Garal97/DMD/Python/Others/test.py

#import os

#txt_files = [f for f in os.listdir ('.') if f.endswith ('.webm')]
#musicfile = txt_files [-1]

#musicfile = os.rename (musicfile, '0'+musicfile)

keys = [
    'key0',
    'key1',
    'key2',
    'key3',
    'key4',
    'key5',
    'key6',
    'key7',
    'key8'  
]

for c in range (0, 9):
    print (keys [c])

for c in range (0, 9):
    print (keys [c])
